OrkunAliOzkan/MarsRover/webapp/client/images/mars_surface.jpeg

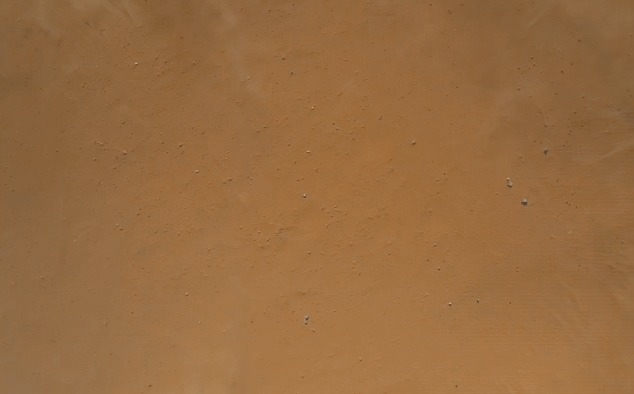
webapp/client/images/mars_surface.jpeg
