OrkunAliOzkan/MarsRover/webapp/client/images/rover.jpg

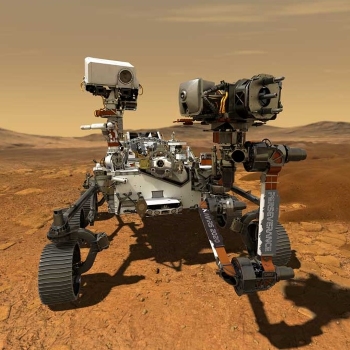
webapp/client/images/rover.jpg
