OrkunAliOzkan/MarsRover/README.md

# Mars Rover

Imperial EEE/EIE Second Year Final Project

## Read the report

  [Project Report](doc/Second_Year_Summer_Project_Report.pdf)
