OrkunAliOzkan/MarsRover/webapp/README.md

## How to deploy the app:

Start the server:  
````node server.js````

Webapp landing page URL:  
````localhost:3000````

Connect rover to this URL:  
````localhost:3001````
