OrkunAliOzkan/MarsRover/webapp/server/database.md

Database 

Total Number of Missions

Duration ()
min, max, avg

Distance Travelled ()
min, max, avg

Success Rate (x / 7 targets found)
min, max, avg

targets : 6 aliens and 1 fan

Mission Queries:
-----------------
sort by start date
sort by success rate
sort by duration
-----------------
