OrkunAliOzkan/MarsRover/webapp/client/images/graphic.png

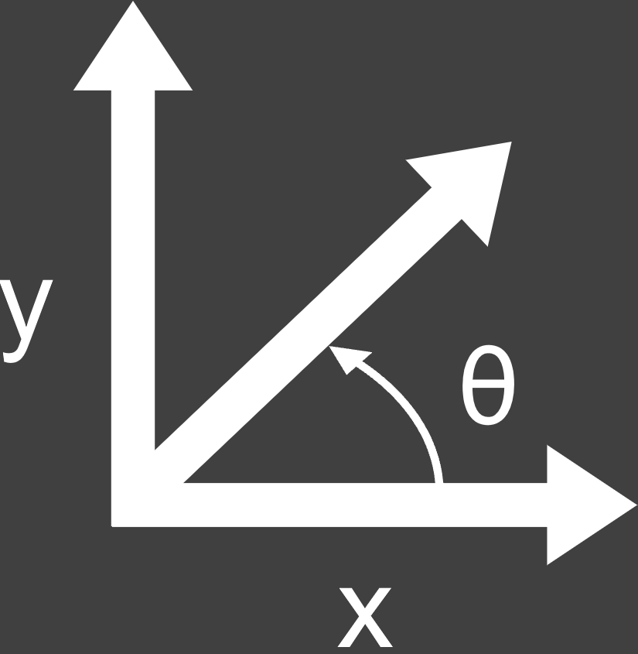
webapp/client/images/graphic.png
