OrkunAliOzkan/MarsRover/webapp/client/images/mars.jpg

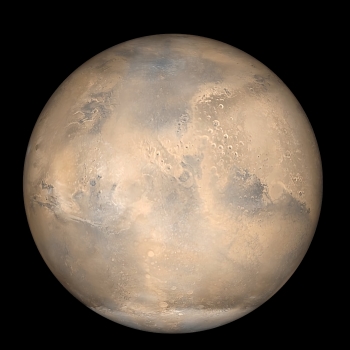
webapp/client/images/mars.jpg
