OrkunAliOzkan/MarsRover/webapp/client/images/mars_bg.jpeg

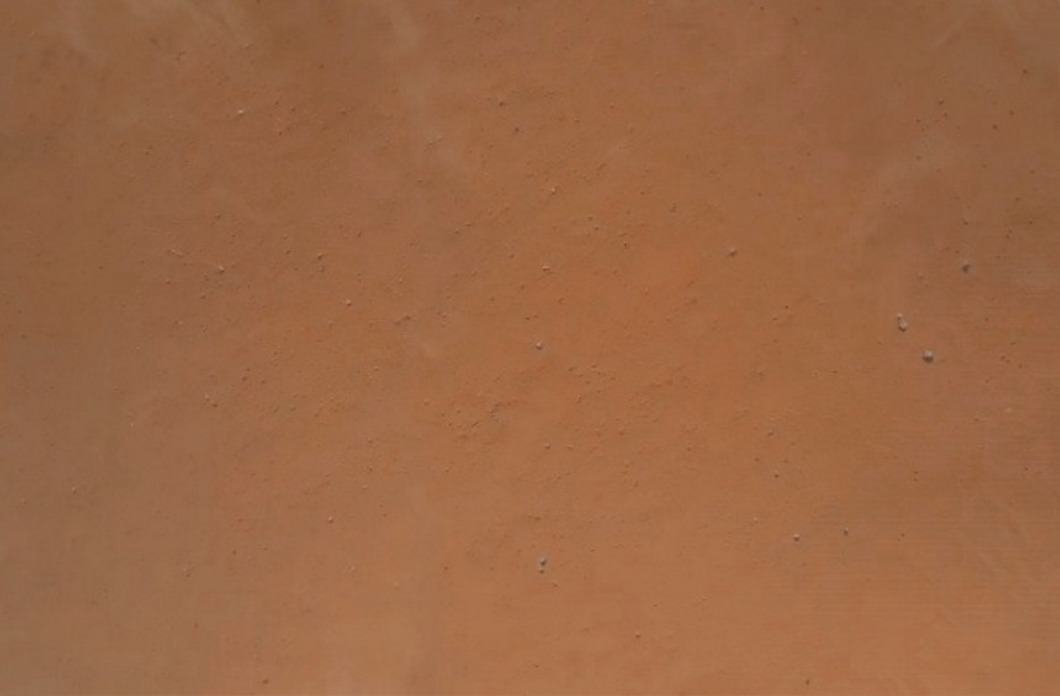
webapp/client/images/mars_bg.jpeg
