OrkunAliOzkan/MarsRover/webapp/client/images/notes.jpg

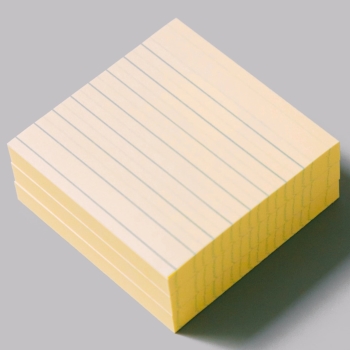
webapp/client/images/notes.jpg
