OrkunAliOzkan/MarsRover/webapp/client/images/rover_3.png

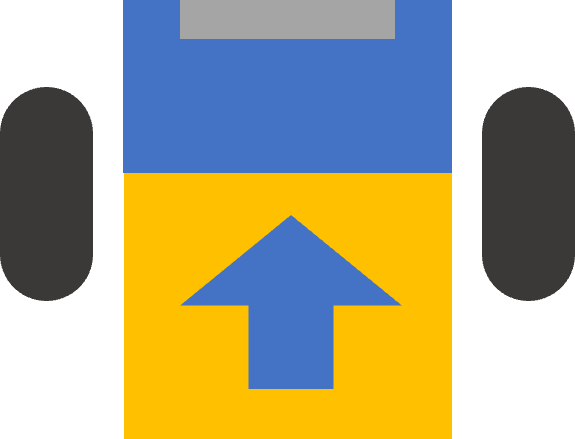
webapp/client/images/rover_3.png
