OrkunAliOzkan/MarsRover/webapp/client/images/surface.png

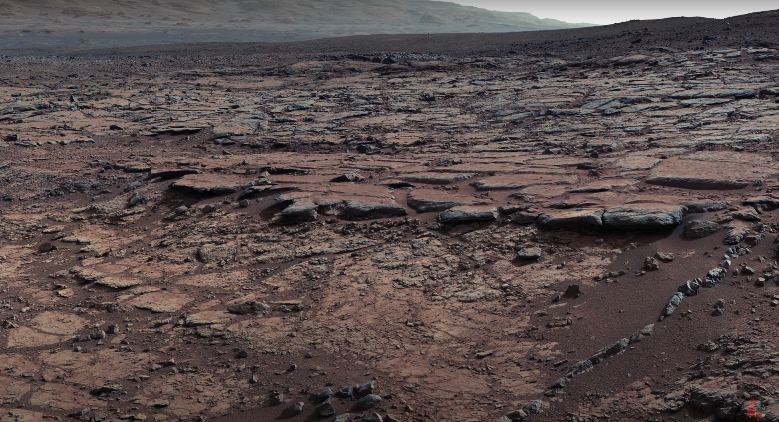
webapp/client/images/surface.png
