OrkunAliOzkan/MarsRover/webapp/client/images/Tiu_Valles_pillars.jpg

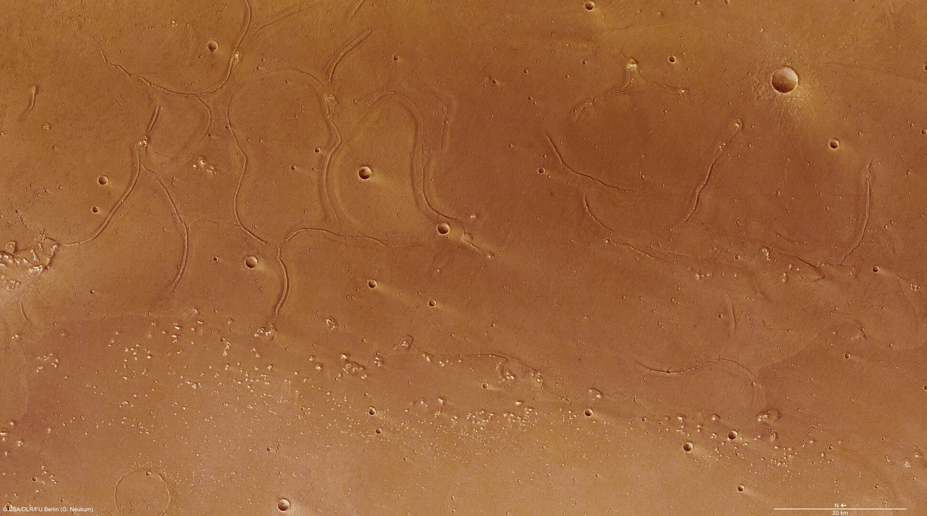
webapp/client/images/Tiu_Valles_pillars.jpg
