OrkunAliOzkan/MarsRover/webapp/client/images/white-abstract-background_23-2148810113.webp

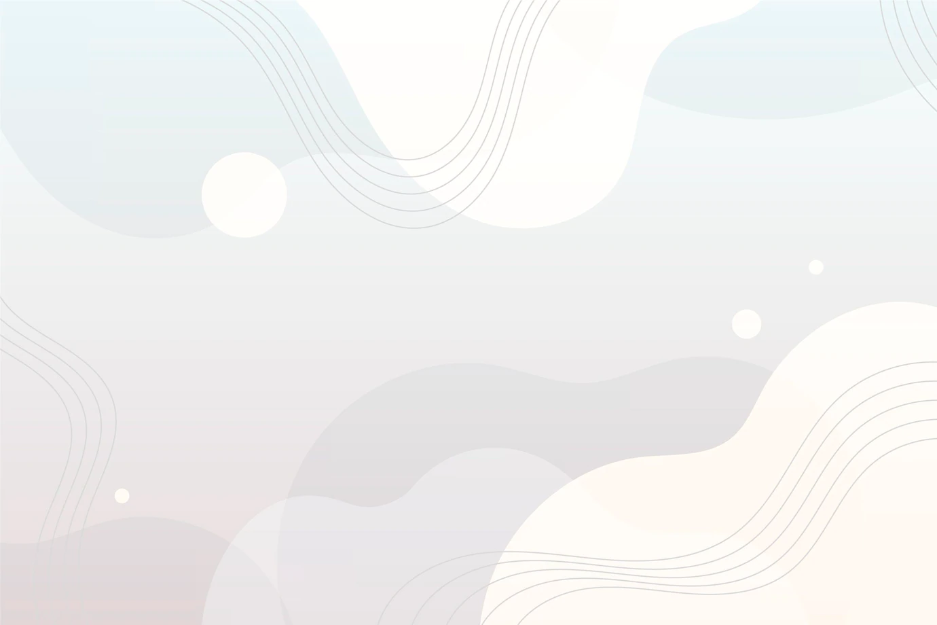
webapp/client/images/white-abstract-background_23-2148810113.webp
