OrkunAliOzkan/MarsRover/webapp/client/trip/images/mars.jpg

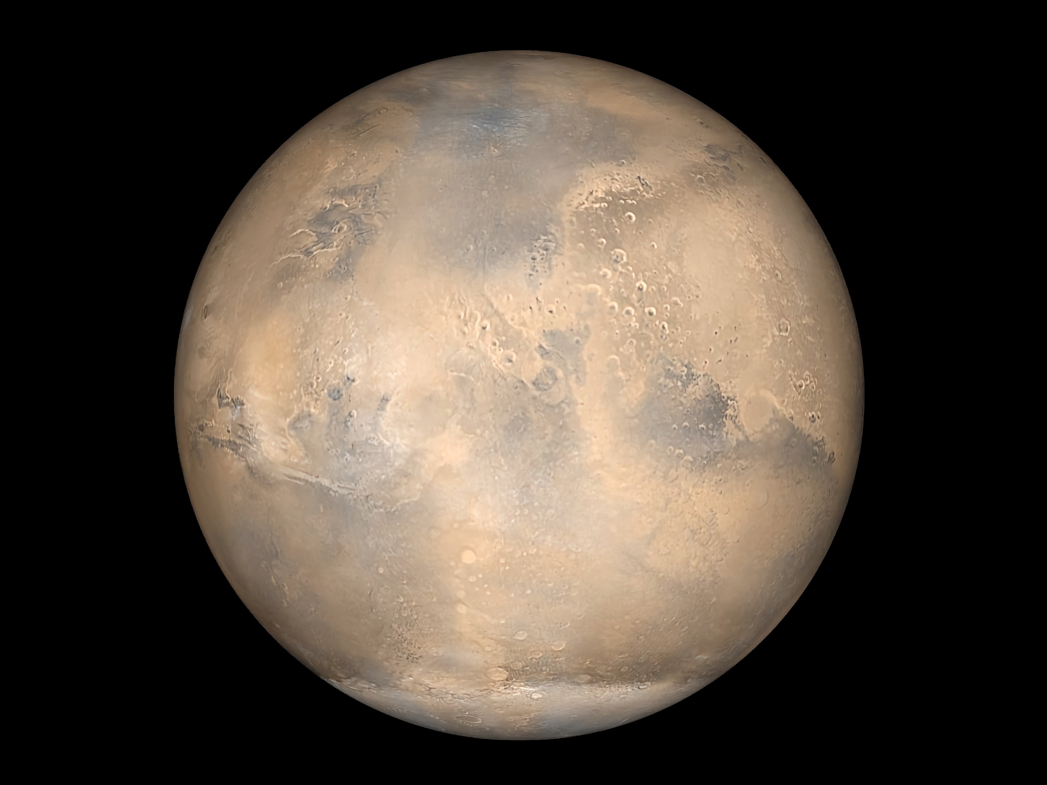
webapp/client/trip/images/mars.jpg
