OrkunAliOzkan/MarsRover/webapp/client/trip/images/spec.jpg

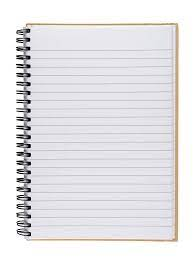
webapp/client/trip/images/spec.jpg
