OrkunAliOzkan/MarsRover/webapp/client/trip/images/team2.png

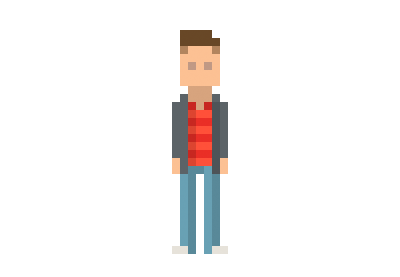
webapp/client/trip/images/team2.png
