OrkunAliOzkan/MarsRover/webapp/client/test/rover_1.png

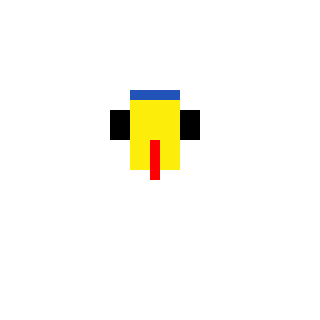
webapp/client/test/rover_1.png
