OrkunAliOzkan/MarsRover/webapp/client/test/rover_2.png

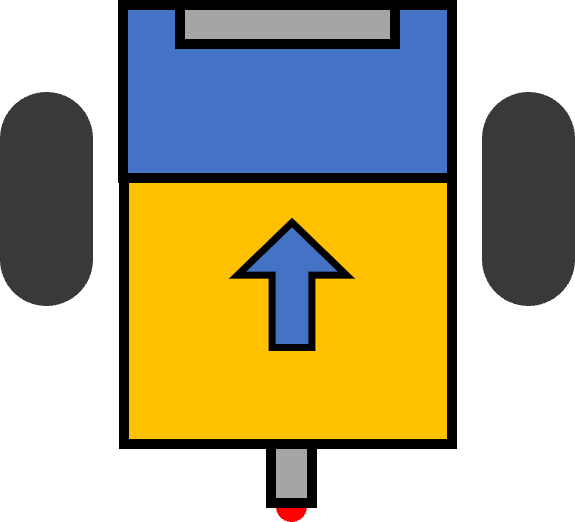
webapp/client/test/rover_2.png
