OrkunAliOzkan/MarsRover/(commit log)

2022-05-31 sockets working
2022-06-03 python - node through sockets
2022-06-17 benchmark graphs
    [http_data.csv, tcp_data.csv]
2022-06-27 sockets destryoed
